irolomos/85-265VAC-5W-1.2A-flyback-converter/(list of files, drawings)

Other design files:
3-) 85VAC-265VAC 6W 5V SMPS FLAYBACK.PrjPcb
85VAC 265VAC 6W 5V SMPS FLAYBACK.SchDoc
85VAC-265VAC 6W 5V SMPS FLAYBACK.PcbDoc
